transistorfet/COMET/CF_Interface_v2/CF_Interface_v2.pdf

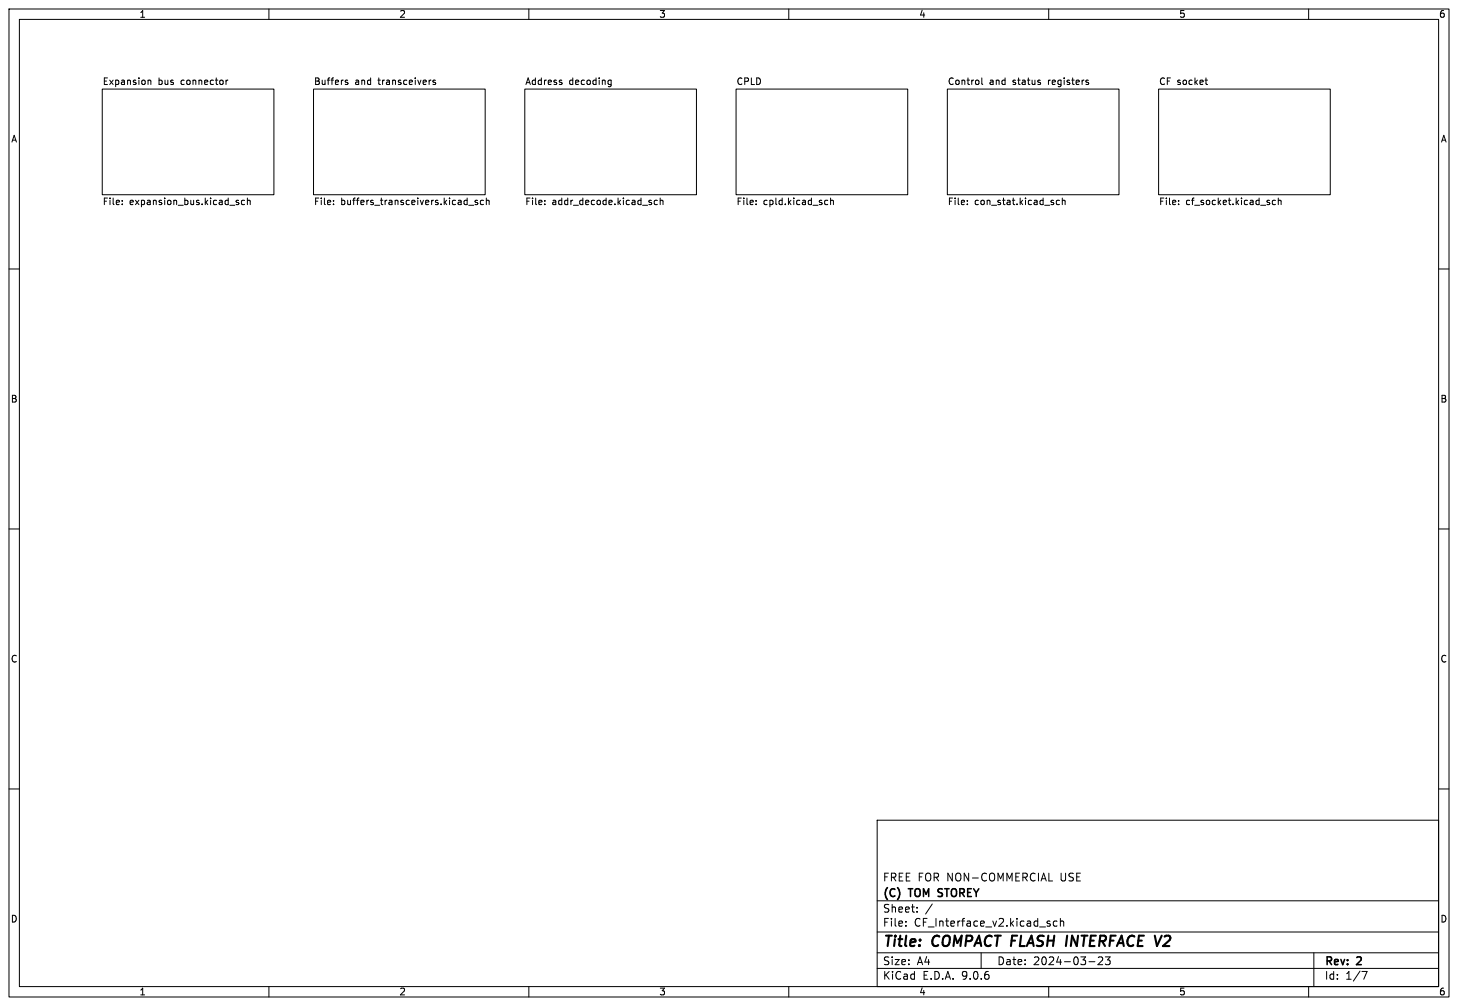
[picture p1: page 1]

Control and status registers File: con_stat.kicad_sch CPLD

Id: 1/7 Title: COMPACT FLASH INTERFACE V2

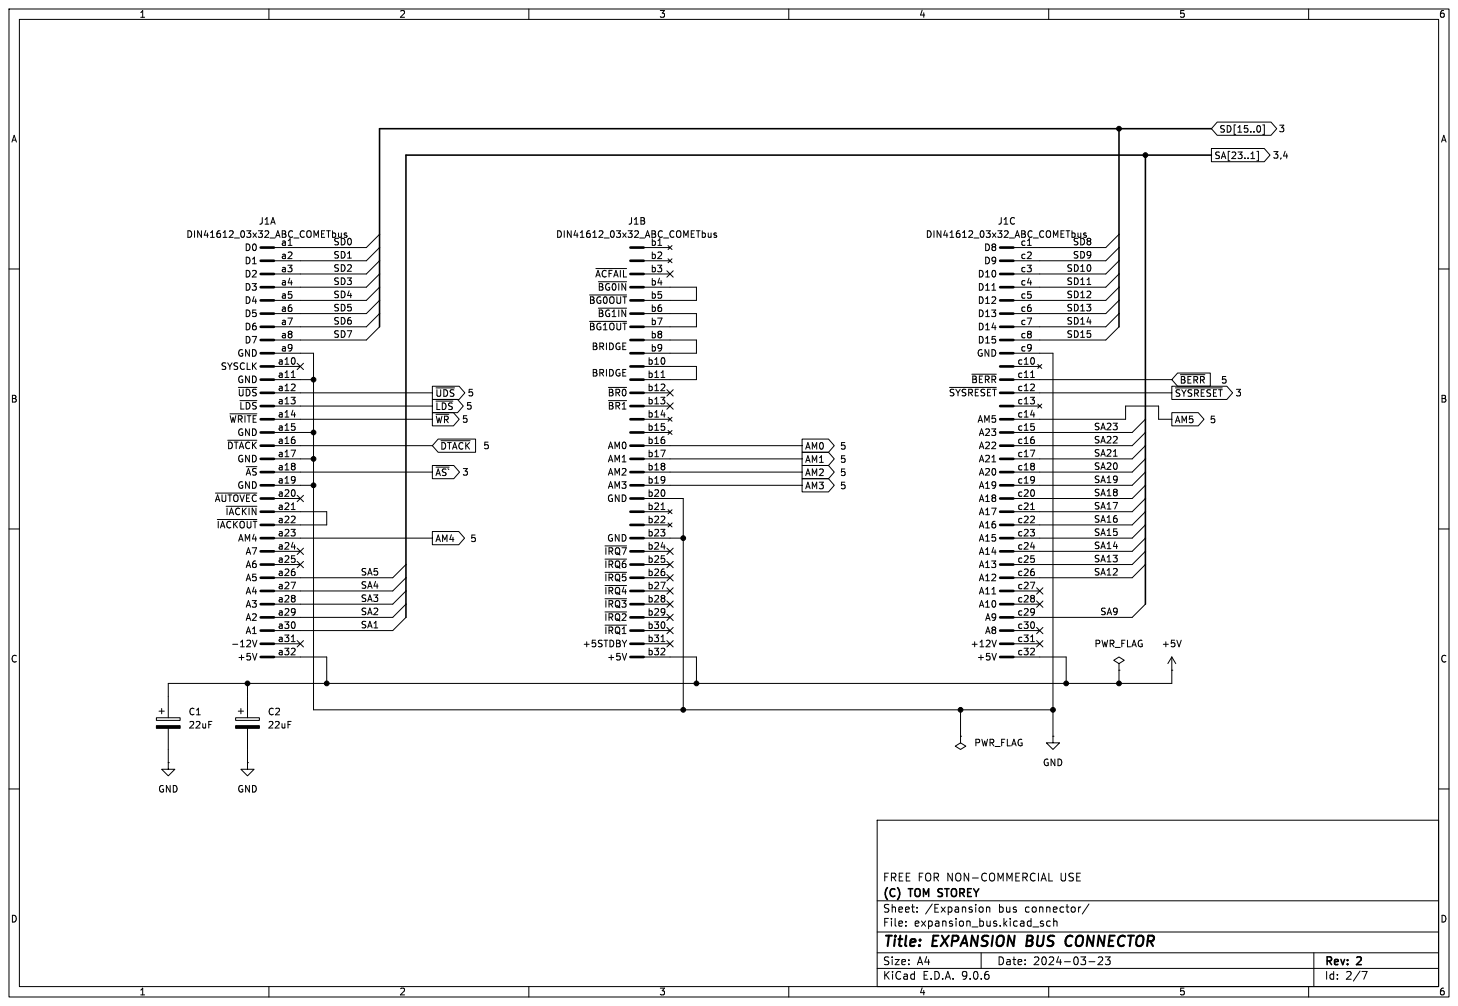
[picture p2: page 2]

Id: 2/7 Title: EXPANSION BUS CONNECTOR

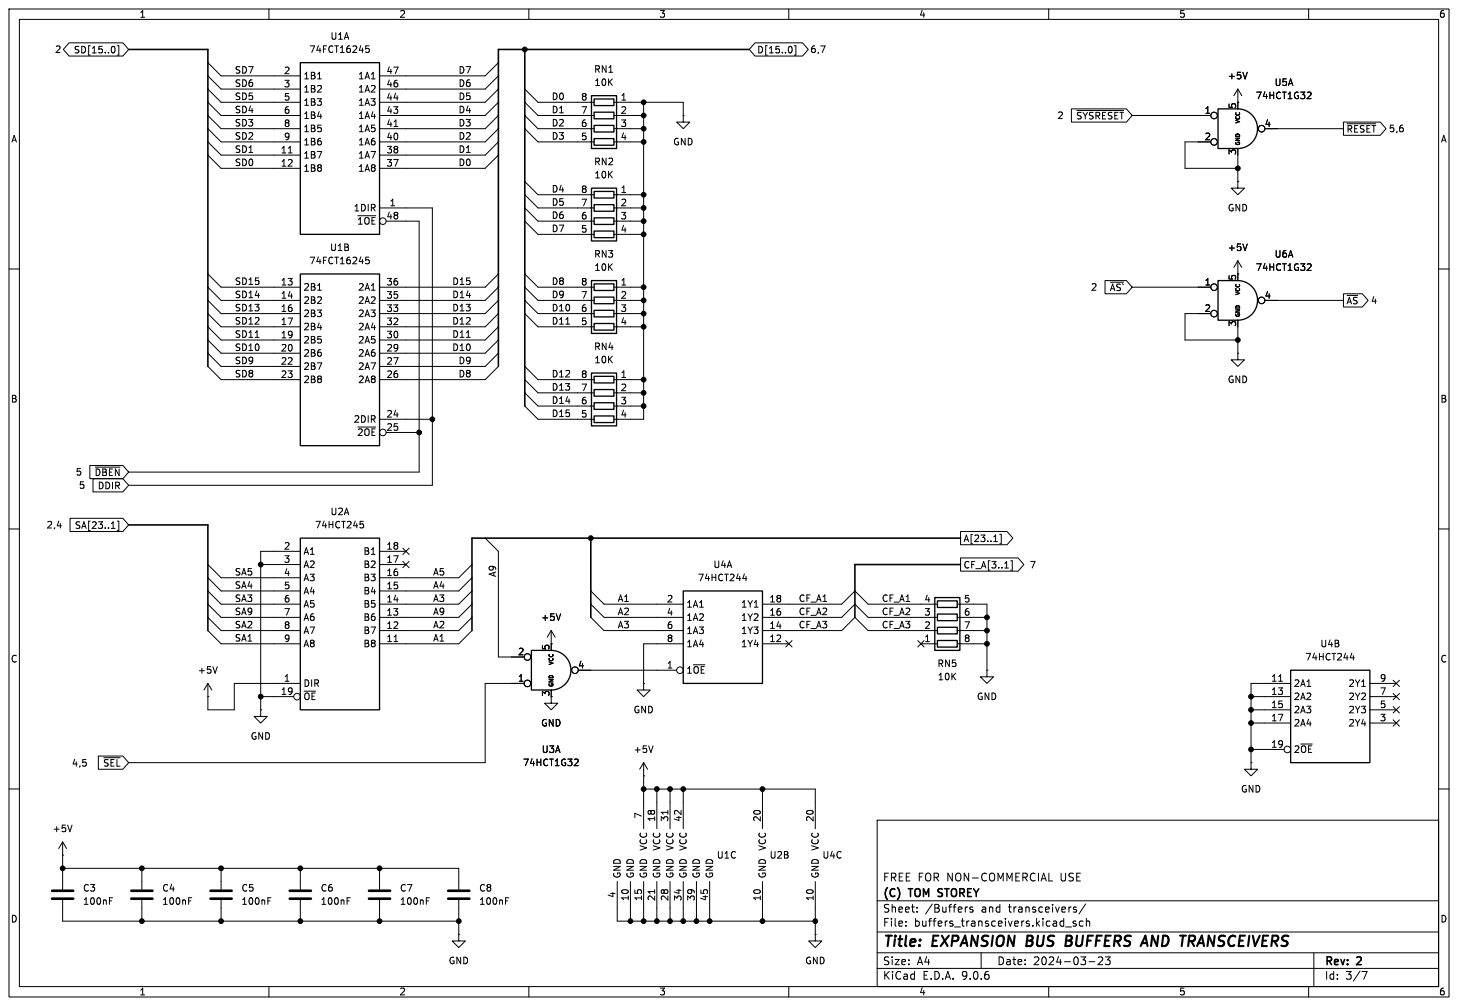
[picture p3: page 3]

7 GND 15 VCC 18 GND 21 VCC 31 GND 28 VCC 42 GND 34 GND 39 GND 45 U1C

Id: 3/7 Title: EXPANSION BUS BUFFERS AND TRANSCEIVERS

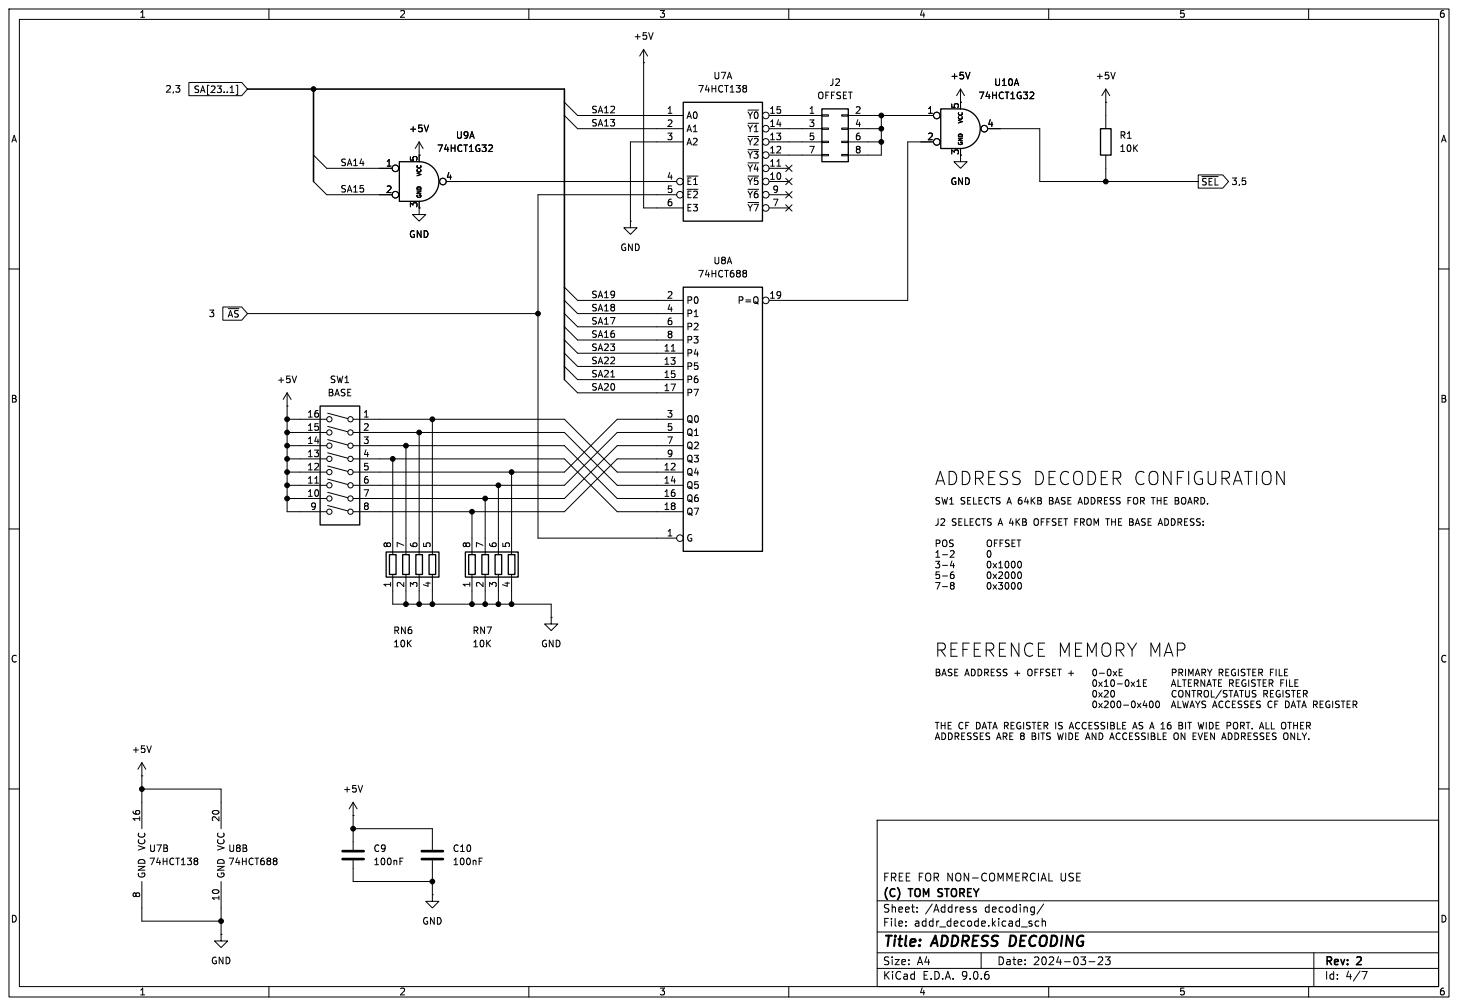
[picture p4: page 4]

ADDRESSES ARE 8 BITS WIDE AND ACCESSIBLE ON EVEN ADDRESSES ONLY. SW1 SELECTS A 64KB BASE ADDRESS FOR THE BOARD. J2 SELECTS A 4KB OFFSET FROM THE BASE ADDRESS: POS OFFSET

THE CF DATA REGISTER IS ACCESSIBLE AS A 16 BIT WIDE PORT. ALL OTHER

(C) TOM STOREY
Id: 4/7 Title: ADDRESS DECODING

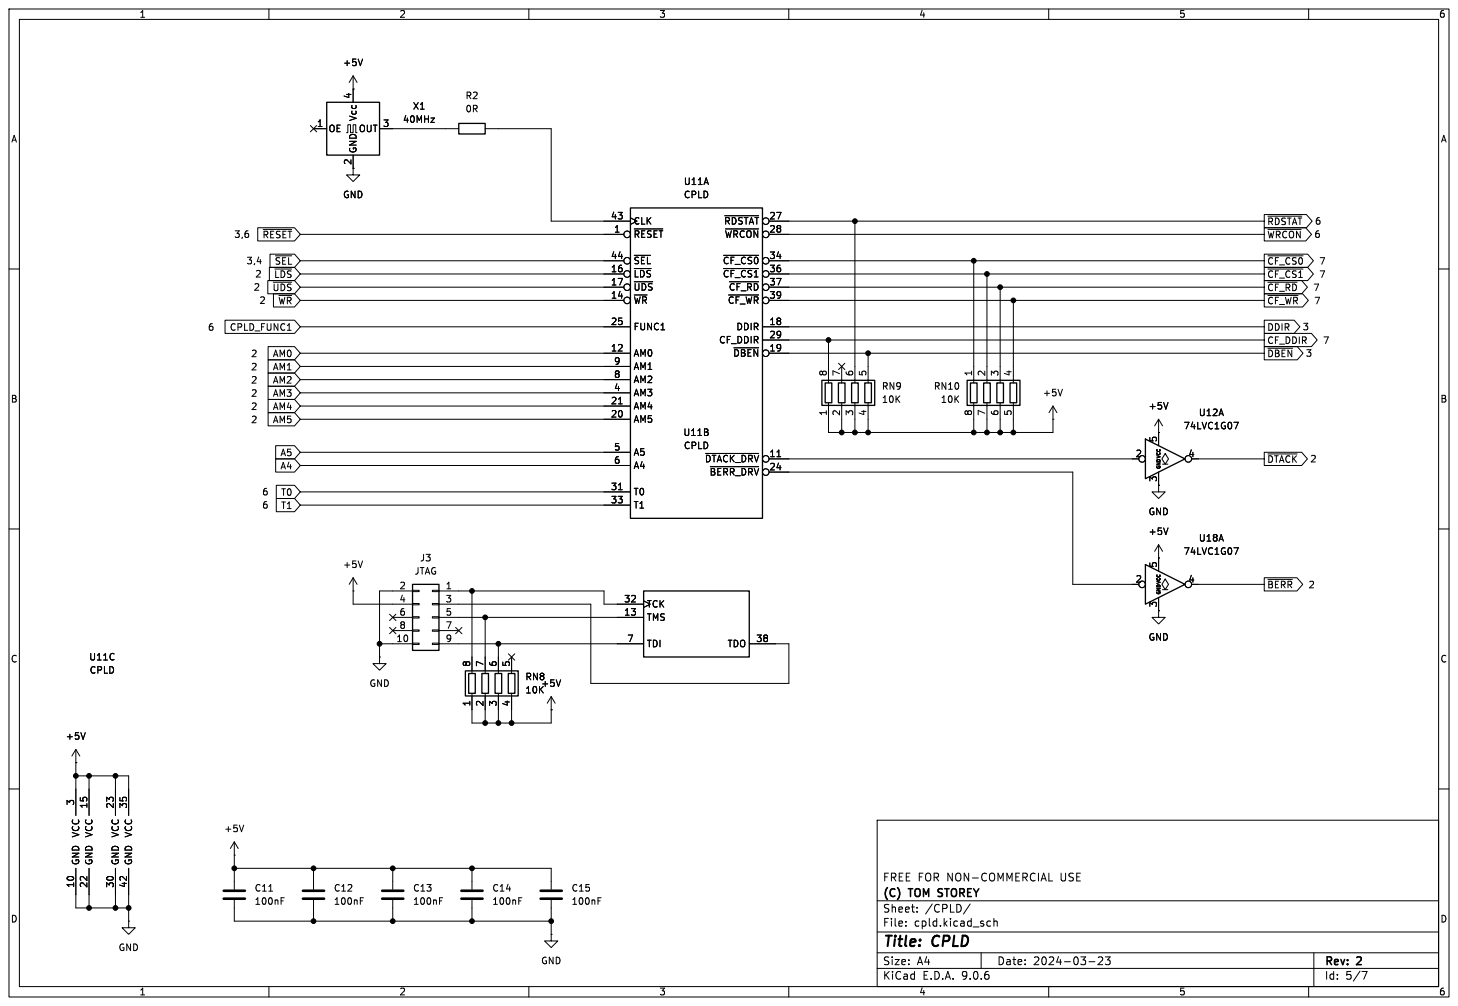
[picture p5: page 5]

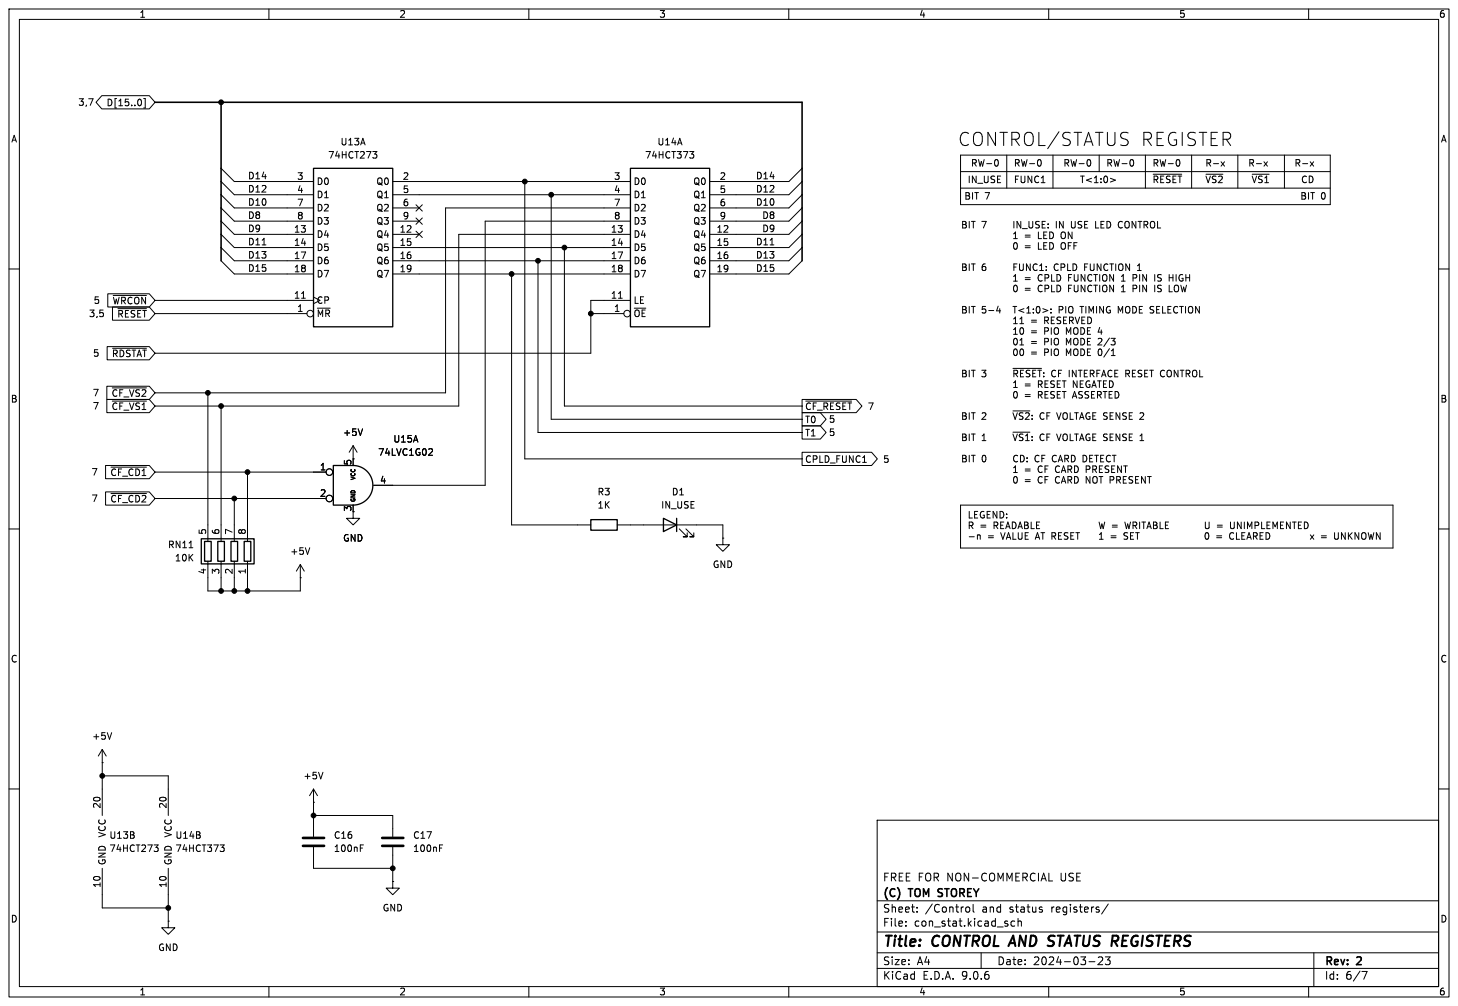
[picture p6: page 6]

IN_USE RW-0 CONTROL/STATUS REGISTER

(C) TOM STOREY
Id: 6/7 Title: CONTROL AND STATUS REGISTERS

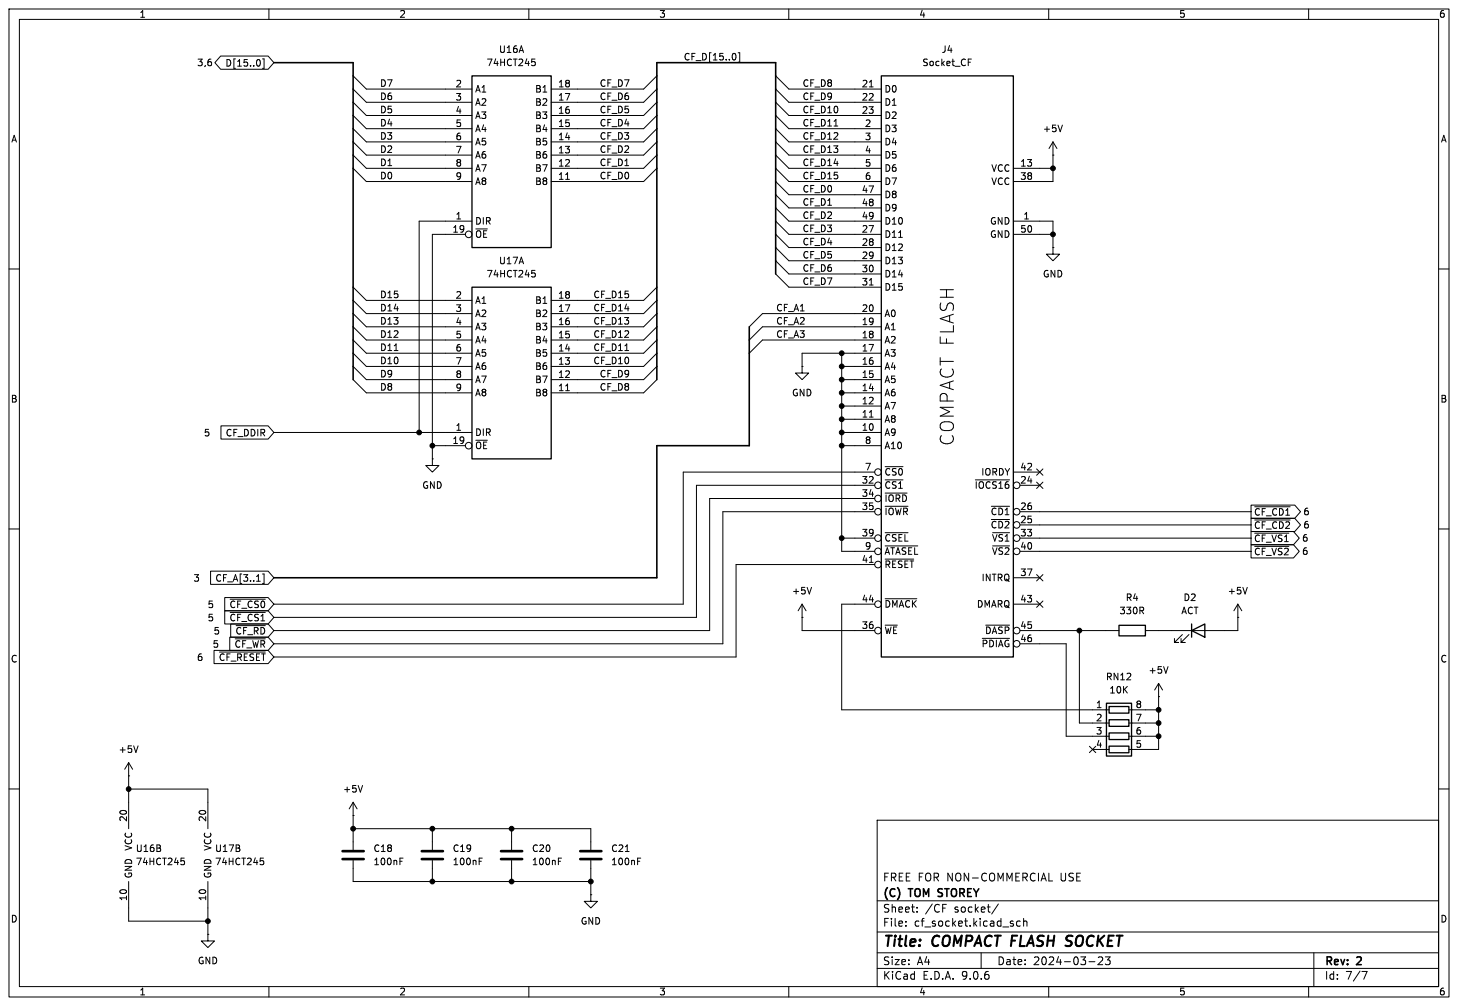
[picture p7: page 7]

Id: 7/7 Title: COMPACT FLASH SOCKET
